CroatianMeteorNetwork/MeteorRadiometer/docs/radiometer_schem_image_cr.jpg

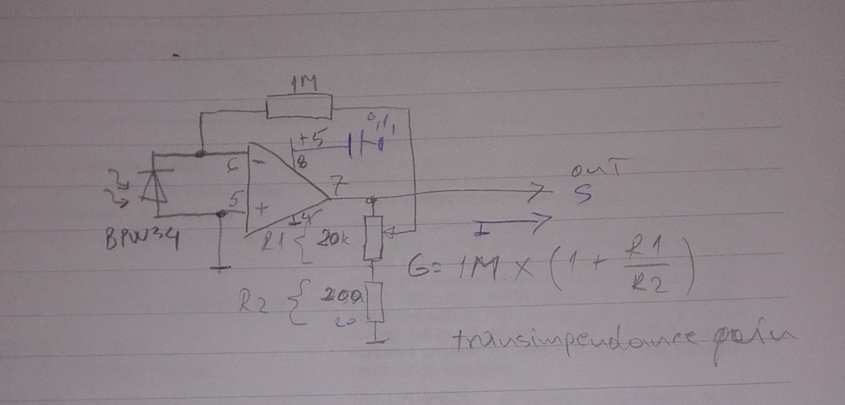
docs/radiometer_schem_image_cr.jpg
