CroatianMeteorNetwork/MeteorRadiometer/docs/Vida_IMC2015_presentation.pdf

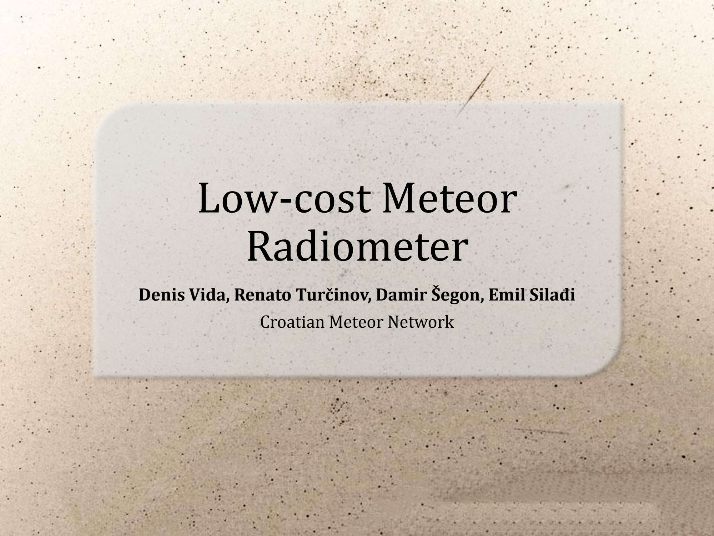
[picture p2: page 1]

## Low-cost Meteor Radiometer

Denis Vida, Renato Turčinov, Damir Šegon, Emil Silađi Croatian Meteor Network

Introduction – radiometric observations?

- First mention in 2001 (Spurný, et al.)

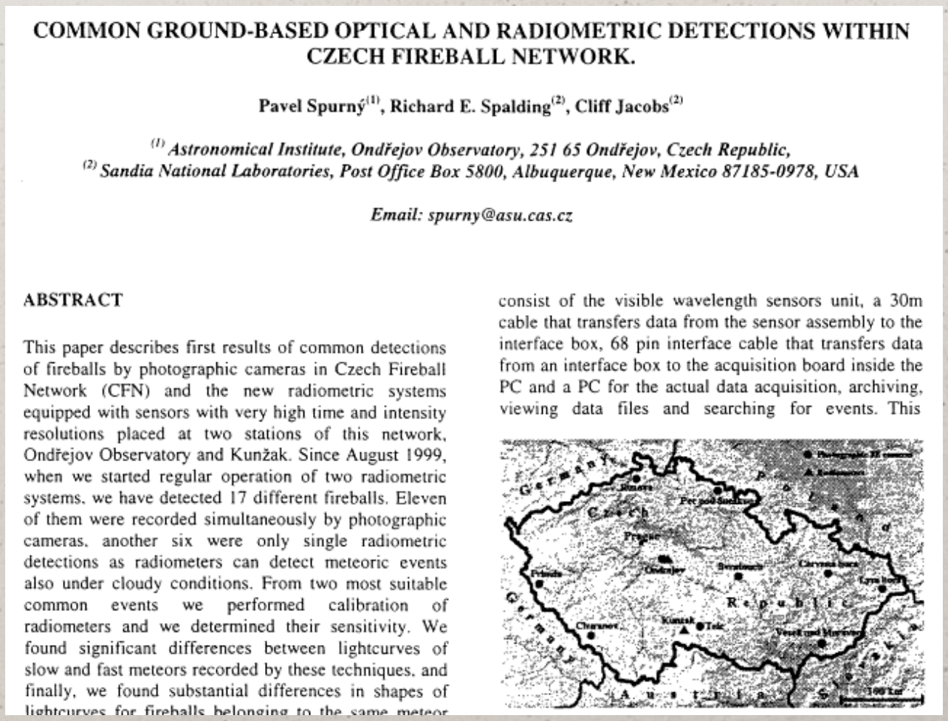
[picture p3: figure]

Source: Spurný, P., Spalding, R. E., Jacobs, C. (2001). “Common ground-based optical and radiometric detections within Czech fireball network”.

Introduction – radiometric observations?

- First mention in 2001 (Spurný, et al.)

„... radiometric systems equipped with sensors with very high time and intensity resolutions...”
„ ... Record total brightness of the sky with sample rate 1200 s⁻¹
... ”

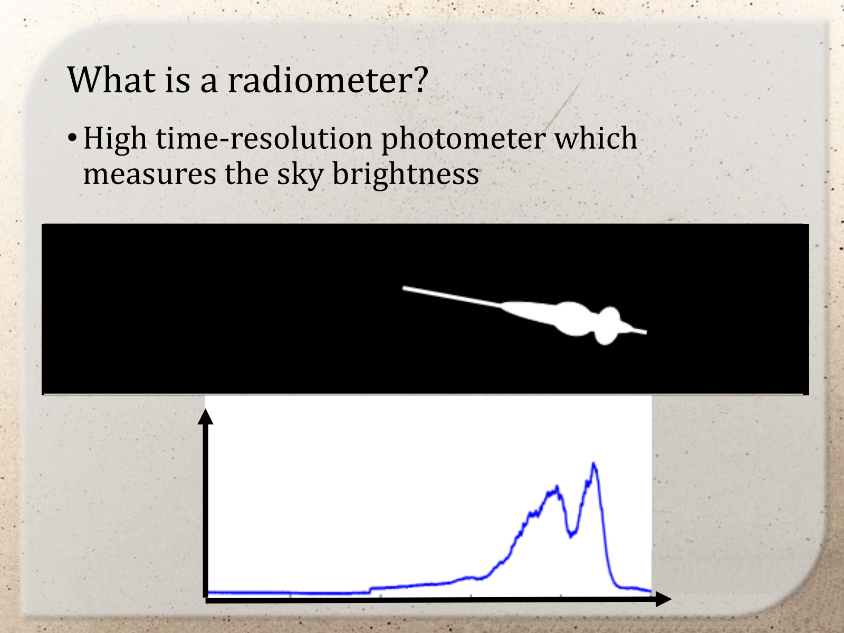
[picture p4: page 4]

What is a radiometer?

•High time-resolution photometer which measures the sky brightness

What is a radiometer?

•High time-resolution photometer which measures the sky brightness

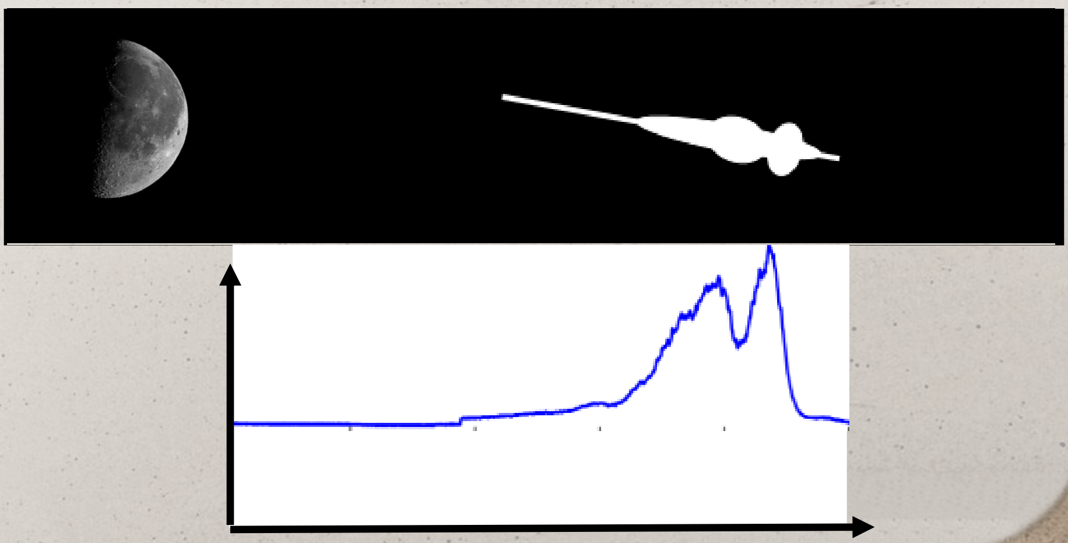
[picture p5: figure]

Why apply them to meteor research?

•Very fine time resolution
- Ultimate fireball fragmentation modelling data! •Unknown high frequency phenomena

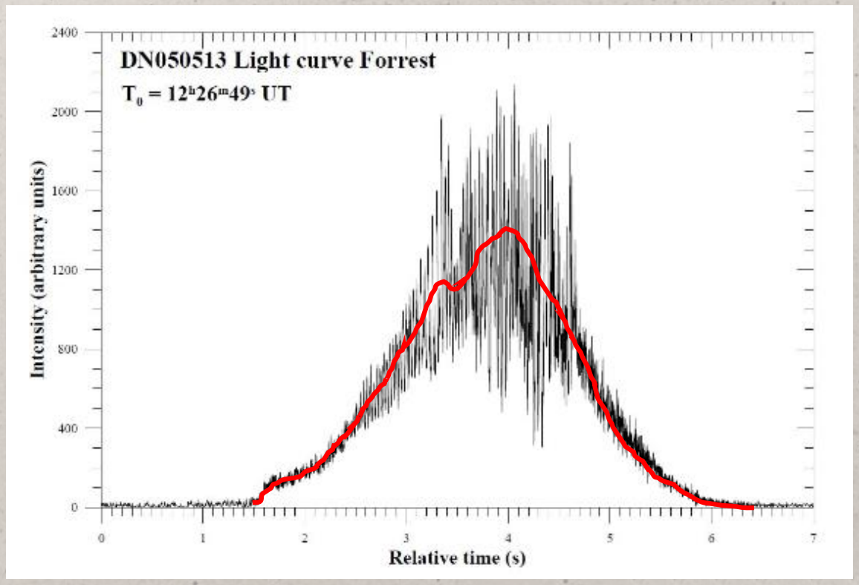
[picture p6: figure]

Source: Borovička J., Spurný P., Brown P. (2015). “Small Near-Earth Asteroids as a Source of Meteorites”.

Building from scratch

- Sensor
- Choice of sensor (photodiode type and choice)
- Sensitivity (10⁻⁵
lux)
- Noise

•Data acquisition
- Sampling frequency (500 Hz, several kilohertz?)
- Precision (16-bit, 24-bit?)
- Acquisition device throughput?

•Cost!

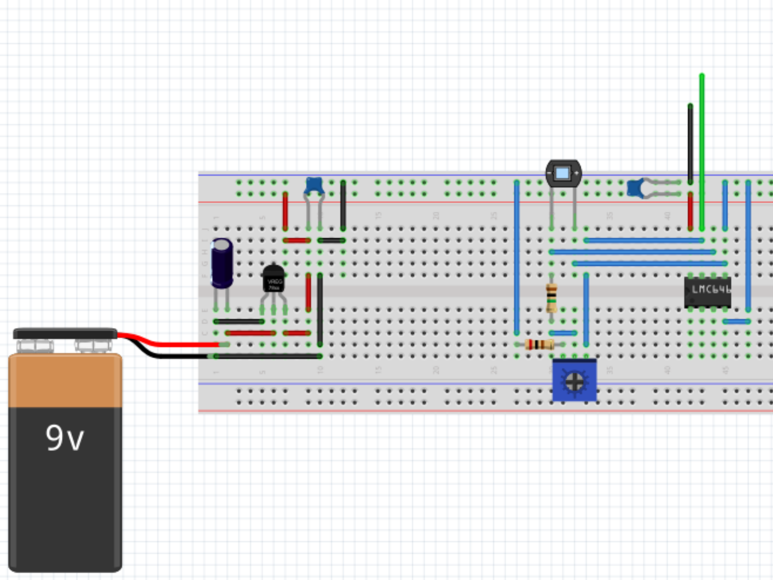
[picture p7: page 8]
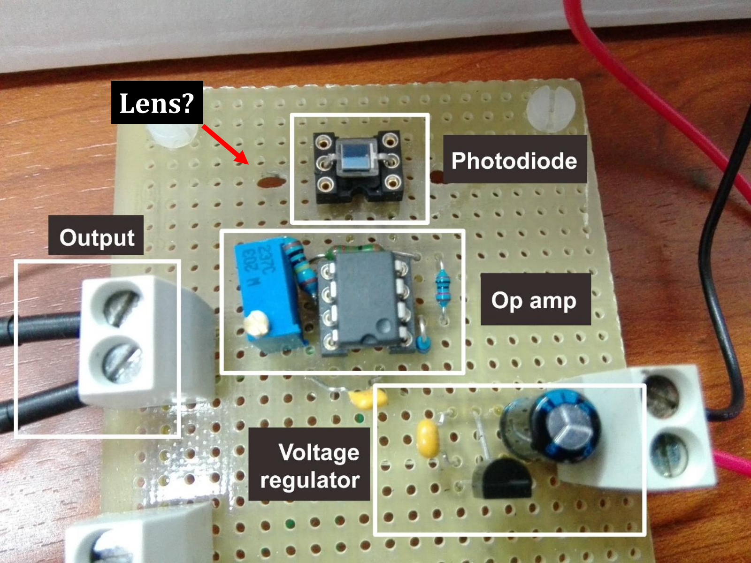
[picture p8: page 9]

Lens?

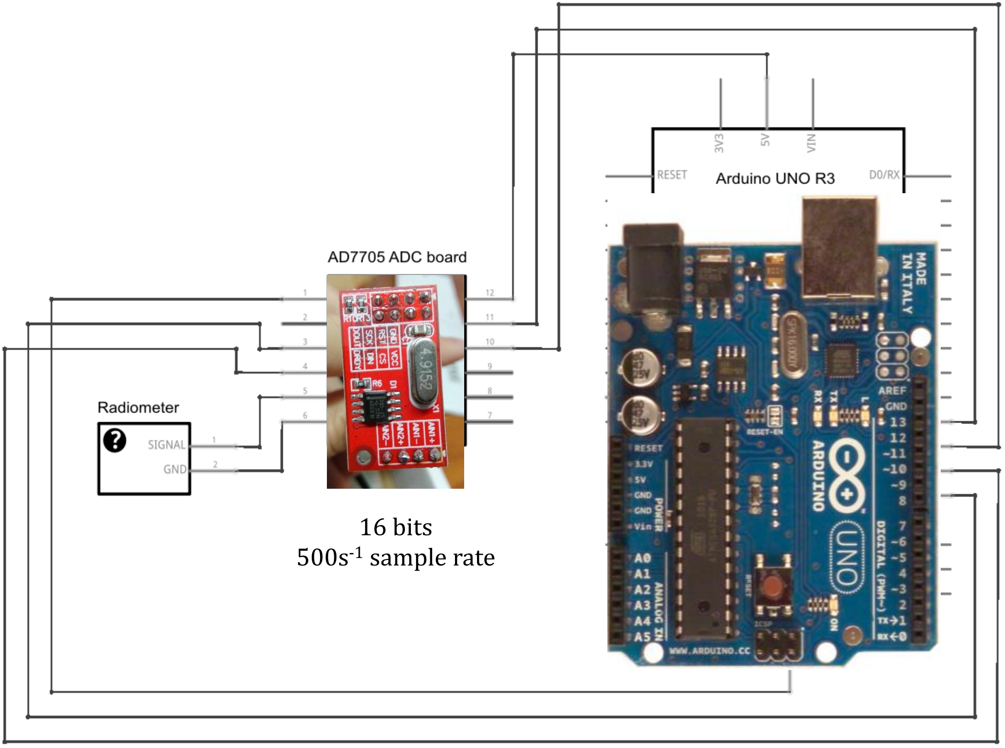
[picture p9: page 10]

16 bits
500s⁻¹ sample rate

Testing - Frequency characteristics

•Tested with f = 83Hz square wave signal
- 3nd harmonic at 3*f = 249 Hz

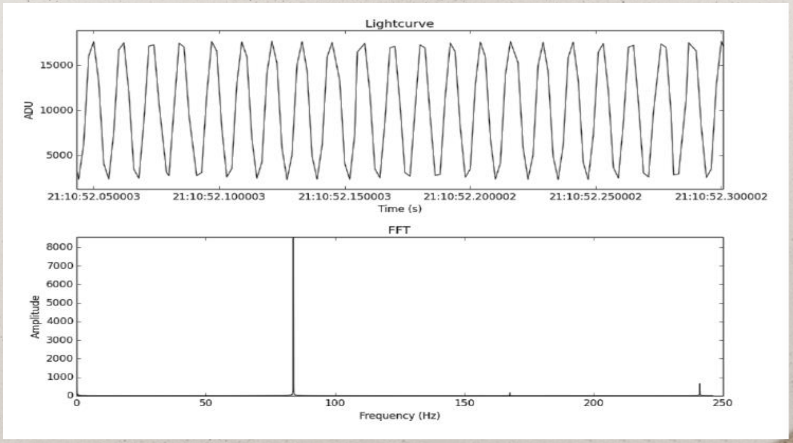
[picture p10: figure]
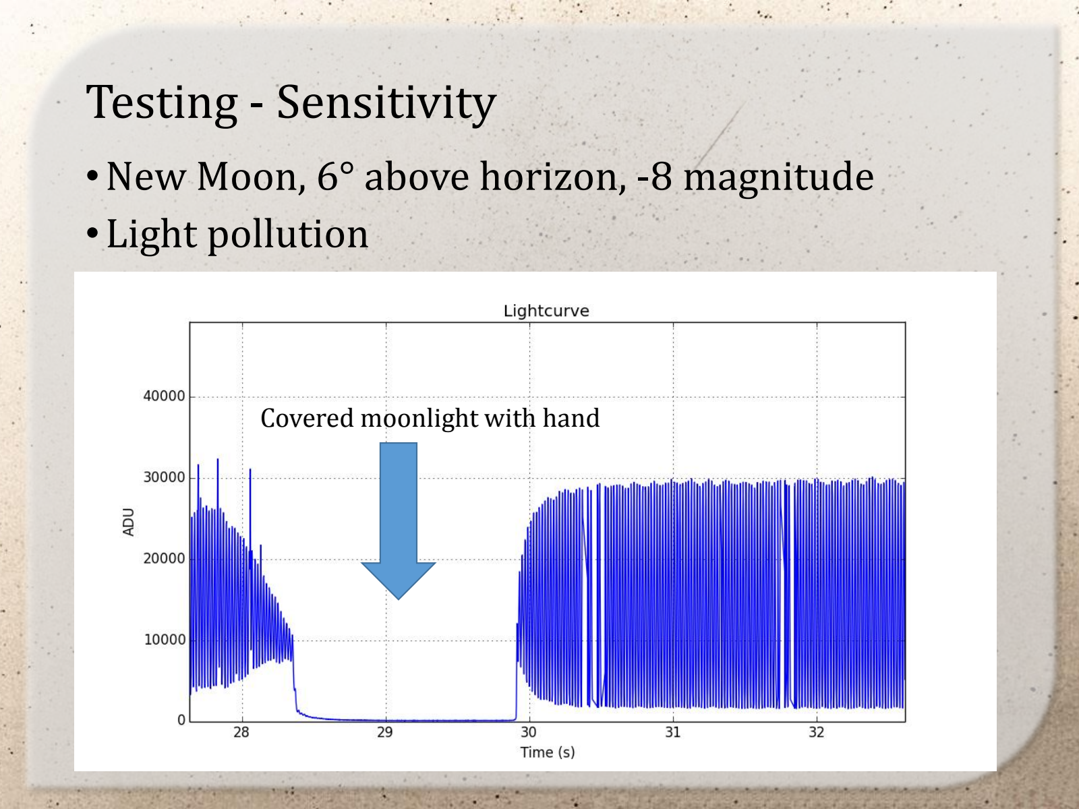
[picture p11: page 12]

Testing - Sensitivity

•New Moon, 6° above horizon, -8 magnitude
- Light pollution

Covered moonlight with hand

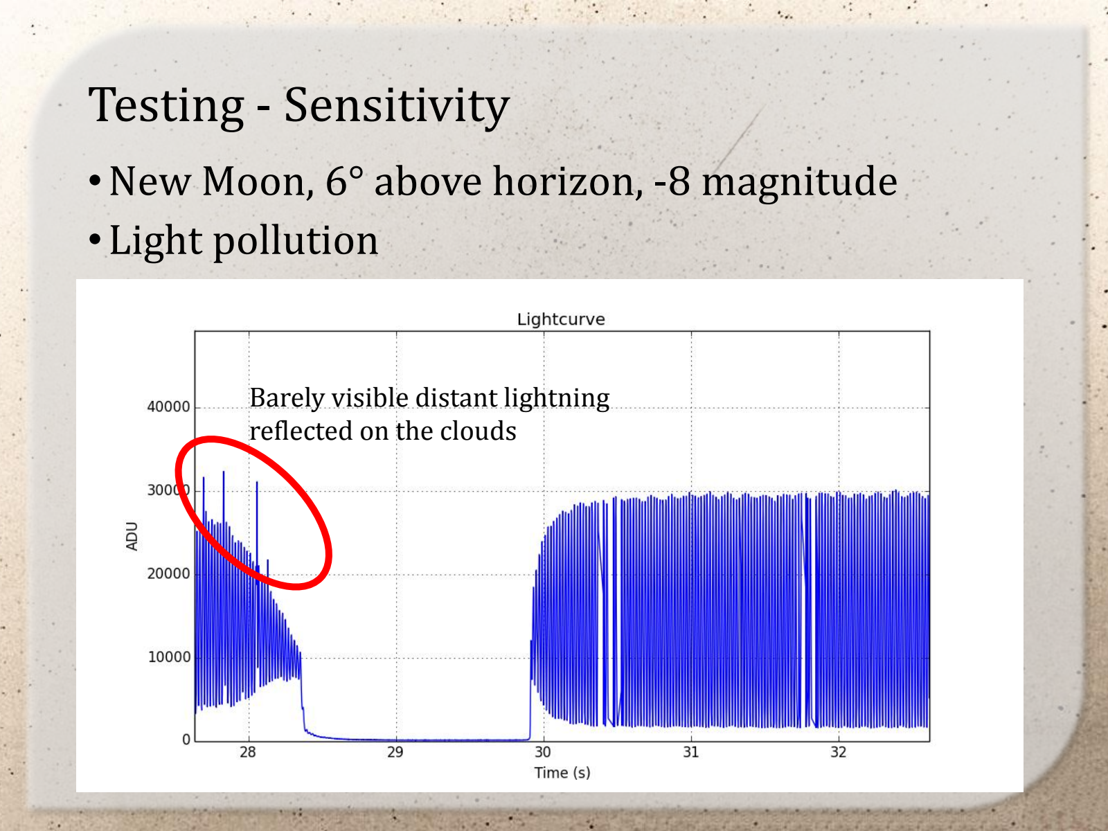
[picture p12: page 13]

Testing - Sensitivity

•New Moon, 6° above horizon, -8 magnitude
- Light pollution

Barely visible distant lightning reflected on the clouds

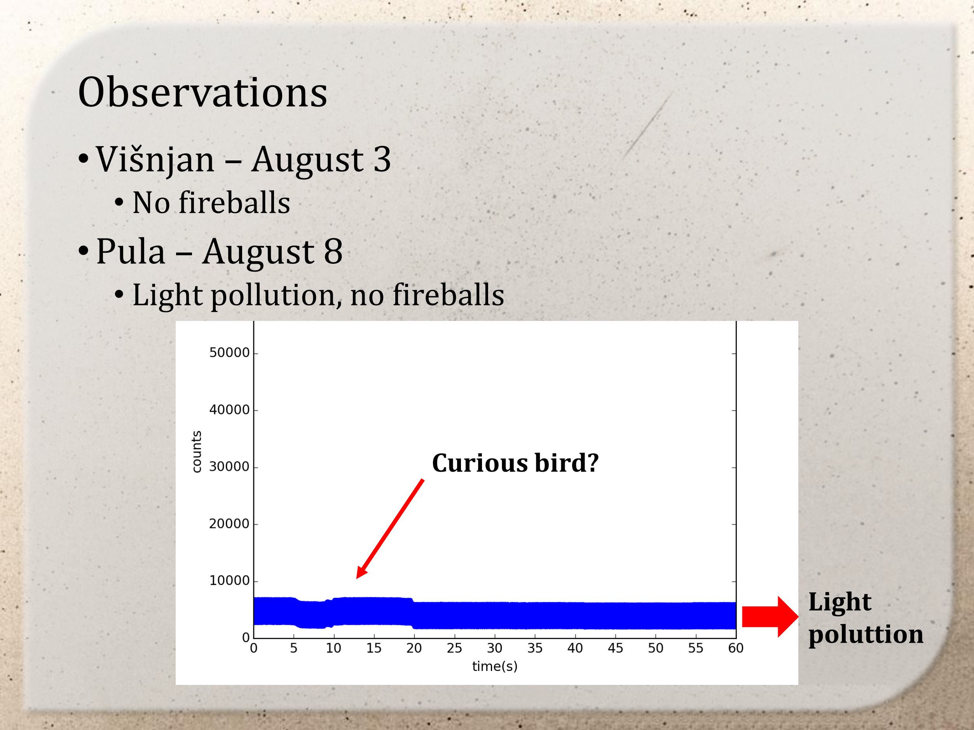
[picture p13: page 14]

Observations

•Višnjan – August 3
- No fireballs
•Pula – August 8
- Light pollution, no fireballs

Light
poluttion

Curious bird?

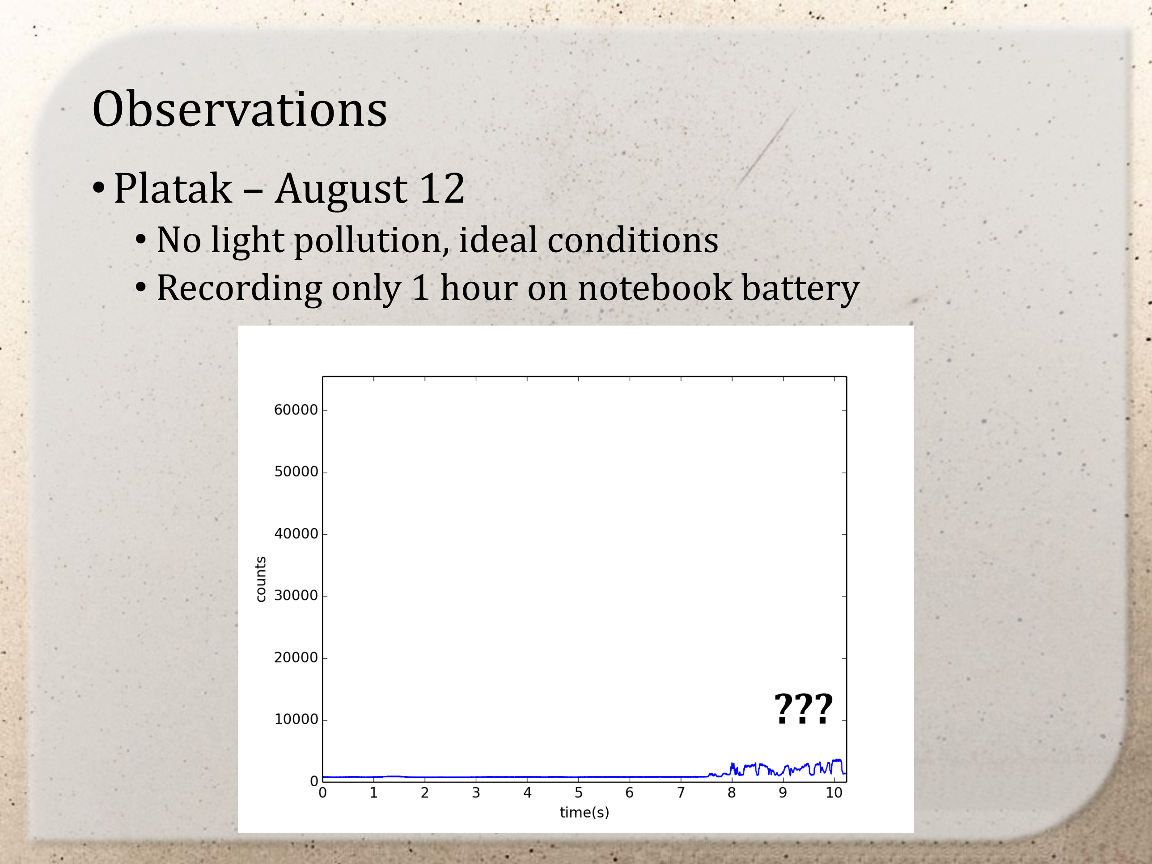
[picture p14: page 15]

Observations

•Platak – August 12
- No light pollution, ideal conditions
- Recording only 1 hour on notebook battery

???

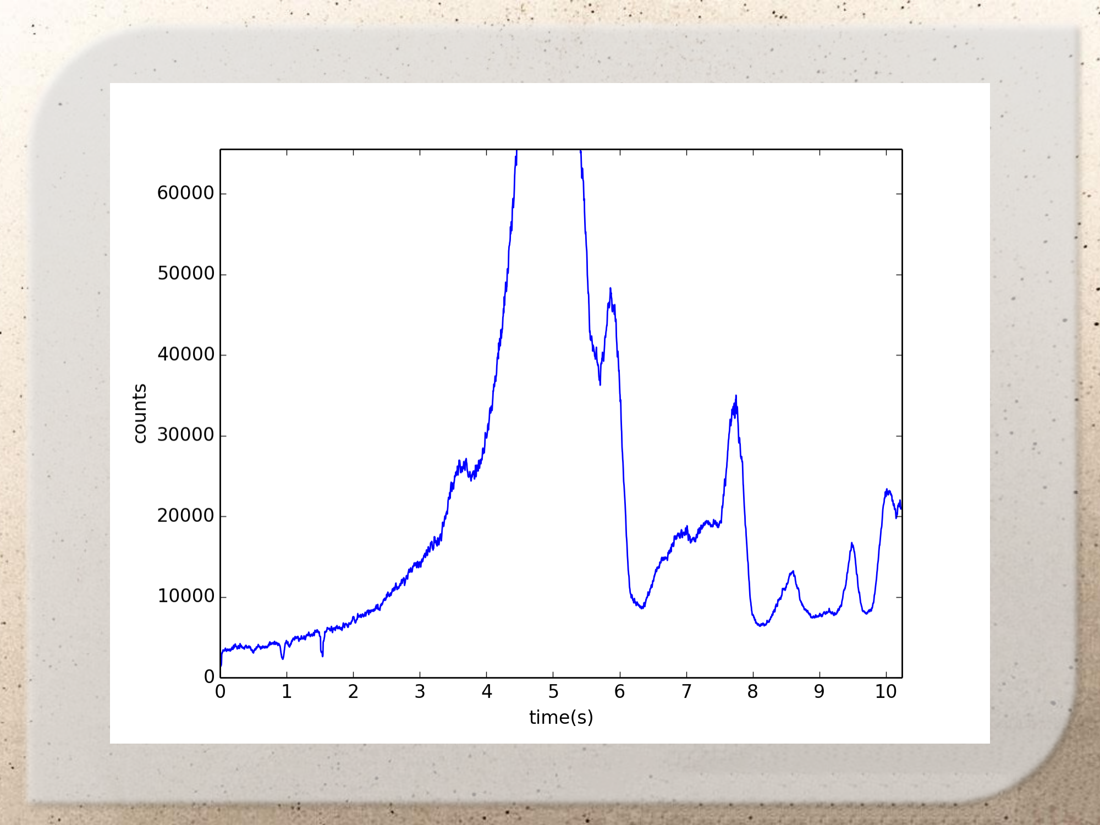
[picture p15: page 16]
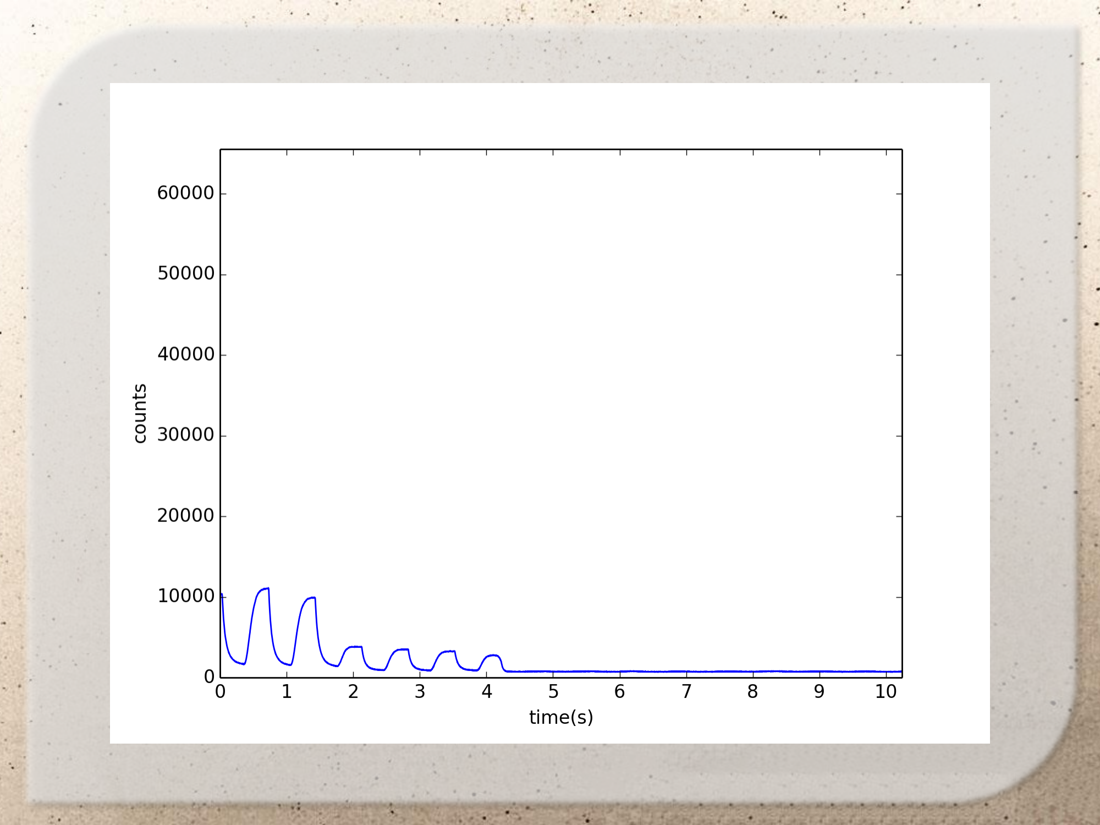
[picture p16: page 17]

Conclusion

•No results so far – More testing!
•Need better observing conditions •All-sky camera next to the radiometer •Improve sampling frequency - several kHz •Improve bit precision – 24-bits
•Improve sensitivity?

•Waiting for a big fireball!

Highlights

What I want you to remember:
•We need radiometers – unknown high frequency phenomena
•They help at fireball modelling

What I want you to do:
•Build your own radiometer (details in the proceedings), test it!
•Improve and share!

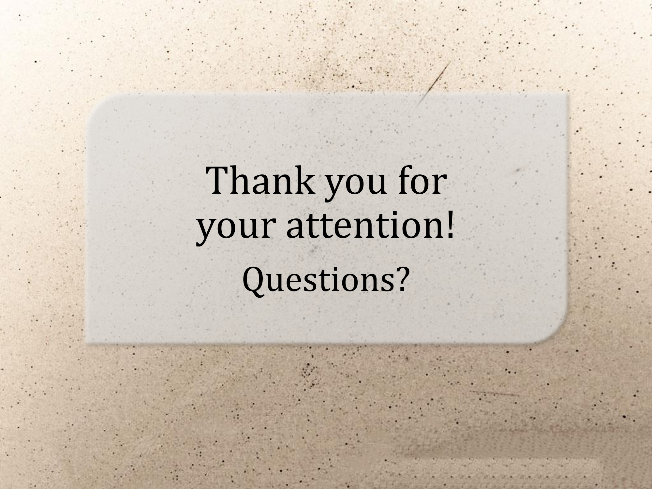
[picture p17: page 20]

## Thank you for your attention!

## Questions?
