CroatianMeteorNetwork/MeteorRadiometer/docs/Radiometer Schematics.png

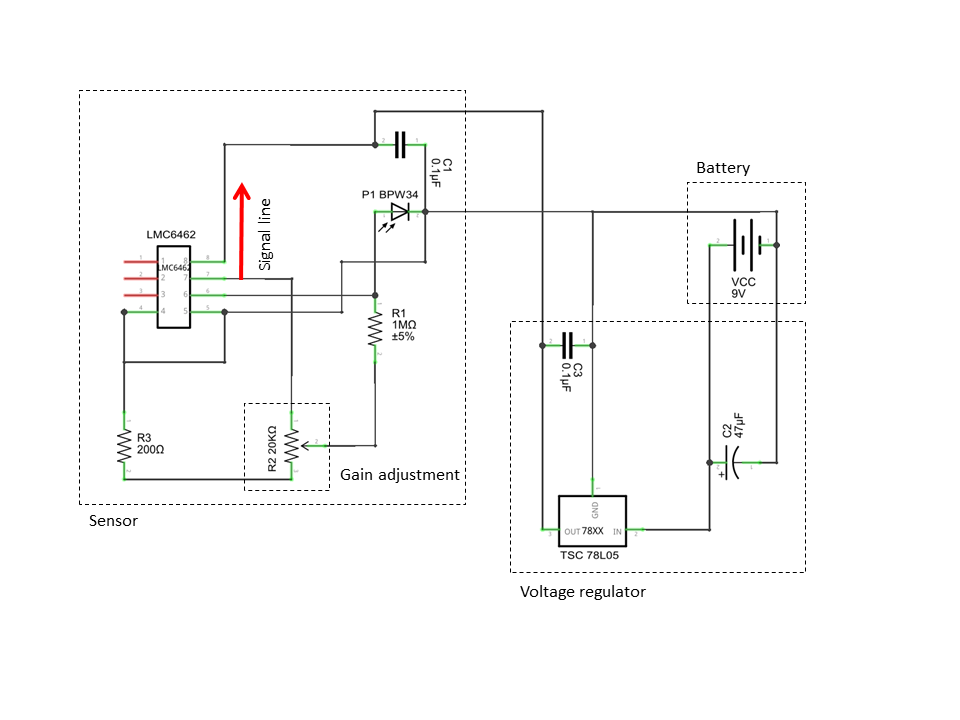
docs/Radiometer Schematics.png
