CroatianMeteorNetwork/MeteorRadiometer/docs/radiometer_Arduino_schem.png

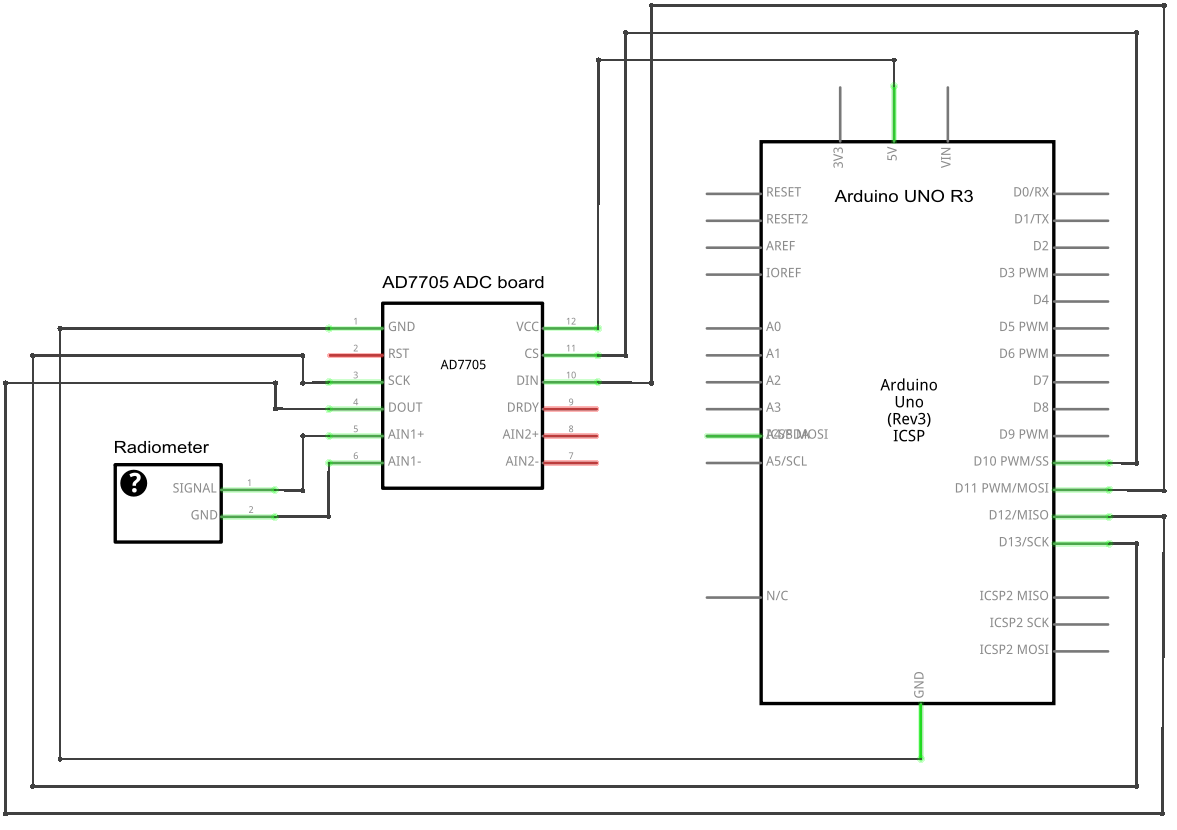
docs/radiometer_Arduino_schem.png
