CroatianMeteorNetwork/MeteorRadiometer/docs/schem_breadboard_annotated.png

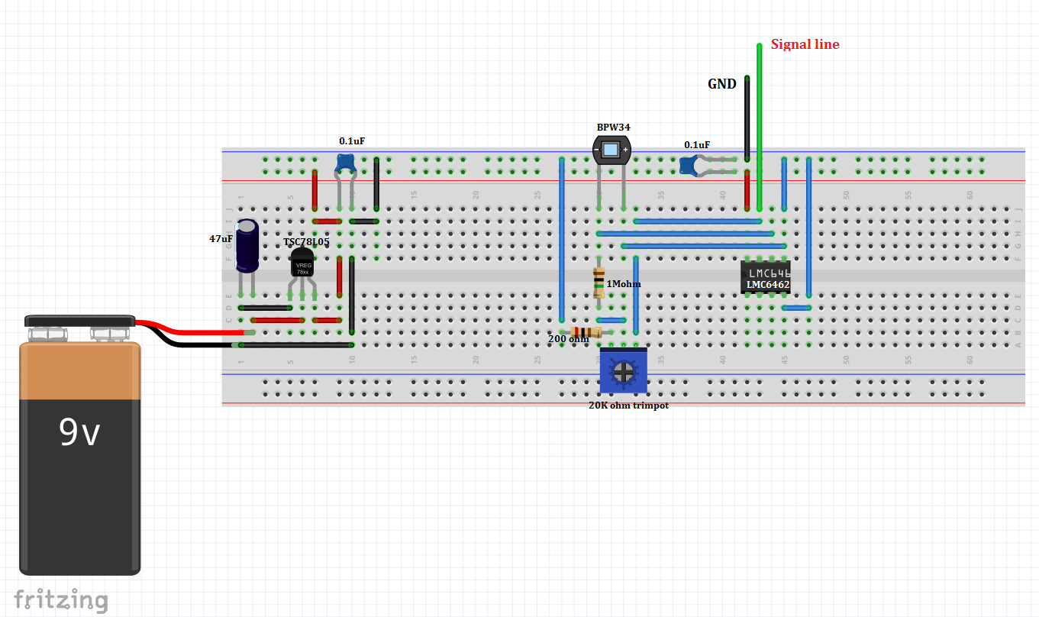
docs/schem_breadboard_annotated.png
