CroatianMeteorNetwork/MeteorRadiometer/Python/readArduino.py

# Script for taking a few seconds of samples from the Radiometer and showing it on the screen

import serial
import time
import matplotlib.pyplot as plt
import numpy as np
import datetime
import matplotlib.dates as mdates


def waitResponse(char):
    """ Wait for response from Arduino while toggling iris. """

    while 1:
        print 'Waiting...'
        time.sleep(0.2)
        ser.write(char)

        if "Response" in ser.readline():
            break


# Length of test in seconds
test_time = 10.0

# Enable FFT graph
fft_enable = False

# Initalize serial connection
ser = serial.Serial('COM3', 115200)

# Wait for initialization
time.sleep(2)

# Open iris
waitResponse("1")

# Wait for the iris to open
time.sleep(2)

print 'Connected!'

data_array = []
times_array = []


counter = 0

# Flush input buffer
ser.flushInput()

first_read = True 
while 1:
    
    if not first_read:
        if (time.clock() - test_start >= test_time):
            break
                
    try:
        b1 = ord(ser.read(1))
        b2 = ord(ser.read(1))
    except:
        continue

    # Calculate ADC value from 2 bytes transfered via COM interface
    serial_value = b1 + b2*256
    if serial_value != '':
        if first_read:
            first_read = False
            test_start = time.clock()
            print 'start', test_start

        #print serial_value

        # Add value to data list
        try:

            # Add data to arrays
            data_array.append(serial_value)
            times_array.append(datetime.datetime.utcnow())

            counter += 1

        except:
            print 'Error!'
            print serial_value
            break

test_duration = time.clock() - test_start

print 'Ending data capture'

# Close iris
waitResponse('0')

# Close serial communication
ser.close()

# Samples per second
sps = len(data_array) / test_duration

print 'Calculated SPS: ', sps

print data_array[0:10]
print 'max:', max(data_array)


# Plot data

if fft_enable:
    import scipy.fftpack
    fig, ax = plt.subplots()
    fig.subplots_adjust(hspace=.3)
    plt.subplot(2, 1, 1)

# Labels
plt.title('Lightcurve')
plt.xlabel('Time (s)')
plt.ylabel('ADU')
plt.plot(times_array, data_array)

plt.ylim((0, 256*256))

# Modify tick number and enagle grid
myFmt = mdates.DateFormatter('%S')
ax = plt.gca()
ax.xaxis.set_major_formatter(myFmt)
ax.grid(True)


# FFT
if fft_enable:
    plt.subplot(2, 1, 2)
    plt.title('FFT')
    plt.xlabel('Frequency (Hz)')
    plt.ylabel('Amplitude')

    # Number of samplepoints
    N = len(data_array)

    # sample spacing
    T = 1.0 / sps
    x = np.linspace(0.0, N*T, N)
    
    y = data_array
    yf = scipy.fftpack.fft(y)
    xf = np.linspace(0.0, 1.0/(2.0*T), N/2)

    fft_amplitude = 2.0/N * np.abs(yf[0:N/2])
    plt.plot(xf, fft_amplitude)
    plt.ylim((0, max(fft_amplitude[5:])))


plt.show()
