CroatianMeteorNetwork/MeteorRadiometer/(commit log)

2015-08-20 added FFT, improved lightcuve X axis ticks
2015-08-29 added timestamped samples + plotting code
2016-03-24 added signal filtering by modelling the noise
2016-08-09 writing data in separate thread, removed timestamping data, automatic recording
2017-07-10 fixed 0s coming from Arduino
    [MeteorRadiometerArduino.ino, readArduino.py]
2017-07-18 fixed plotting to match record script
    [radiometerPlot.py]
2018-08-22 Limited sleep to 1 hour to prevent over-idling and fixed sunrise calculation
    [recordRaspberry.py]
